NeuralSyntaxLab/perch-scale-system/README.md

# NeuralSyntaxLab Perch-Scale project

<p align="left">
    Description
</p>
This repository contains all supplementary materials for the Bird Scale Methods project, including:

1. [Scale design files](https://github.com/NeuralSyntaxLab/perch-scale-system/tree/main/docs/design).
2. [Scale system setup and assembly guides](https://github.com/NeuralSyntaxLab/perch-scale-system/tree/main/docs/manuals).
3. Full parts list and where to purchase them (downloadable [here](https://github.com/NeuralSyntaxLab/perch-scale-system/tree/main/docs/parts)).
4. [Arduino codes](https://github.com/NeuralSyntaxLab/perch-scale-system/tree/main/src/arduino) neccessary for operating the system.
5. [Python scripts](https://github.com/NeuralSyntaxLab/perch-scale-system/tree/main/src/main) necessary for operating the system.

## Scale Design Files
This folder contains the full design of the scale device.
Here you can find '.pdf' files of the base, pin (3D printed Delrin perch) and weight, as well as the design summary page and a '3D-pfd' file for 360 view of the device. Also included is a '.skp' design file for use with CAD programs. Use this file to create the parts yourself.
