NeuralSyntaxLab/perch-scale-system/docs/design/scale_design.md

Assembly1
01_Base
03_Pin
05_Weight
