NeuralSyntaxLab/perch-scale-system/data/examples/weight_report_example_plot.png

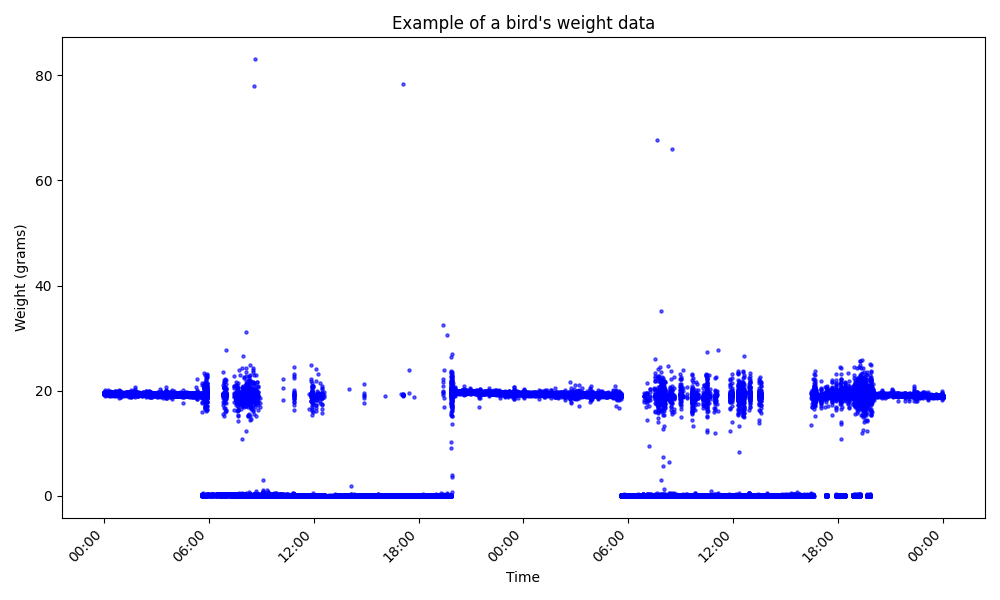
data/examples/weight_report_example_plot.png
