NeuralSyntaxLab/perch-scale-system/docs/parts/Scale_system_parts_list.xlsx

part | URL | cost (per unit) | notes
mini load cell 500g straight bar | https://www.digikey.com/en/products/detail/sparkfun-electronics/SEN-14727/9555601 | 11.25$
Sparkfun Qwiic Scale NAU7802 breakout board (signal amplifier) | https://www.digikey.com/en/products/detail/sparkfun-electronics/SEN-15242/10064419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 | 16.50$
Sparkfun Qwiic MUX breakout board | https://www.digikey.com/en/products/detail/sparkfun-electronics/bob-16784/12714950 | 12.95$
4 Circuit Picoblade plug 425mm (male-to-female) | https://www.digikey.com/en/products/detail/molex/2181130404/14309312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 | 4.24$ | discount for multiple
JST-SM Pigtail connector 4-PIN (male-to-female) | https://www.digikey.com/en/products/detail/sparkfun-electronics/CAB-14576/8543396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 | 1.69$
Flexible Qwiic cables | https://www.digikey.com/en/products/filter/rectangular-cable-assemblies/450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 | 1.00-2.40$
Flexible Qwiic breadboard cable | https://www.digikey.com/en/products/detail/sparkfun-electronics/PRT-17912/13998112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 | 1.60$
4-Core electric cable
Plastic box | https://www.digikey.com/en/products/detail/bud-industries/CU-1874-B/387084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 | 3.30$ | discount for multiple
Raspberry Pi 4 model B | https://www.digikey.com/en/products/detail/raspberry-pi/SC0193-9/10258782 | 45.00$
Raspberry Pi 4 Case | https://www.digikey.com/en/products/detail/raspberry-pi/SC0230/10258767 | 5.00$
32GB microSD memory card |  | ~10.00$ | Purchase locally
Arduino Uno R3 | https://www.digikey.com/en/products/detail/arduino/A000073/3476357 | 26.30$
Self-Built Scale Parts
3D printed Delrin perch | Manufacture with your own resources based on the suplpied design
Steel clinder (counterweight) |  |  | 3 pcs: 200+100+100 grams
