NeuralSyntaxLab/perch-scale-system/docs/design/pdfs/Assembly1.pdf

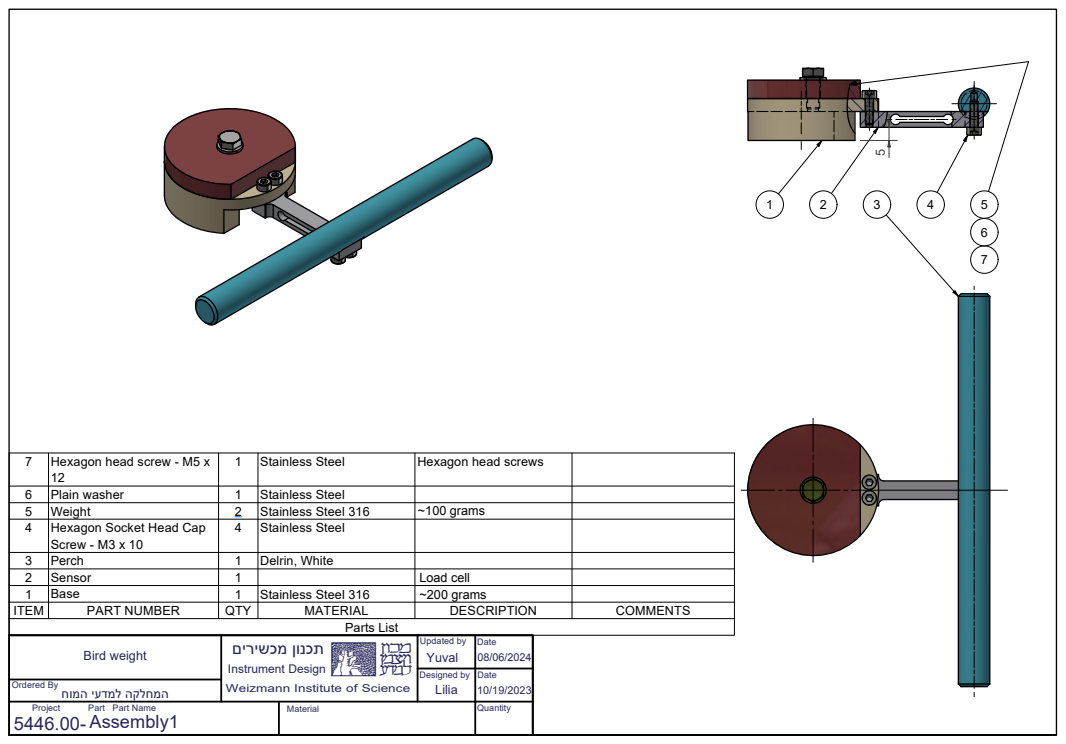
[picture p13: page 1]
Parts List

7 | Hexagon head screw - M5 x 12 | 1 | Stainless Steel | Hexagon head screws

6 | Plain washer | 1 | Stainless Steel
5 | Weight | 2 | Stainless Steel 316 | ~100 grams
4 | Hexagon Socket Head Cap Screw - M3 x 10 | 4 | Stainless Steel

3 | Perch | 1 | Delrin, White
2 | Sensor | 1 | | Load cell
1 | Base | 1 | Stainless Steel 316 | ~200 grams
ITEM | PART NUMBER | QTY | MATERIAL | DESCRIPTION | COMMENTS

Bird weight | Instrument Designzx תכנון מכשירים | Updated by Yuval | Date 08/06/2024

Designed by Lilia | Date 10/19/2023

Weizmann Institute of Science Ordered By

המחלקה למדעי המוח

Project Part Part Name 5446.00- Assembly1 | Material | Quantity
