NeuralSyntaxLab/perch-scale-system/(commit log)

2025-11-18 Revise Scale System Setup Guide for clarity and detail
    Updated the Scale System Setup Guide with detailed instructions on system operation, configuration, and calibration processes. Added clarifications and improved formatting for better readability.
2026-01-06 Edit links
    Updated the link for the general part list and remove redundant information about the 4-pos connector which is in the parts list mentioned.
2026-01-18 Add images and re-organize repository
    [Assembly1.stp, Scale_system_parts_list.xlsx]
2026-01-18 update repository structure #2
    [Assembly1.stp]
2026-01-18 Revise Scale System Assembly Guide with new links and images
    Updated links and added figures for better clarity in the assembly guide.
2026-01-18 Update Scale System Assembly Guide.md
2026-01-18 Revise Scale System Setup Guide with updated links and figures
    Updated links to part lists and assembly guides. Added figures for schematic overview and wiring scheme. Revised calibration instructions and examples.
